agorbaty27/tree-climbing-robot/Motor_2_holders_v2.3mf

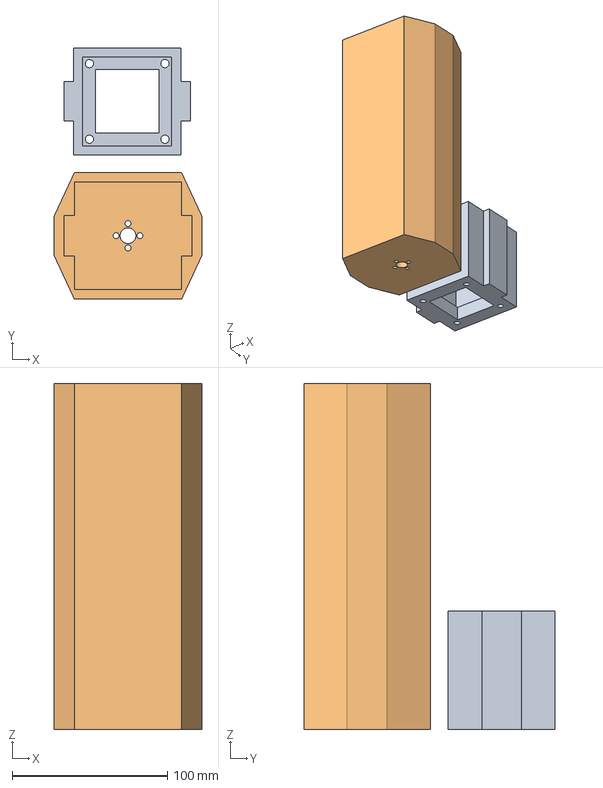
[picture p1: CAD file, 2026-10-24]
Motor_2_holders_v2.3mf
95.0 x 161.7 x 222.8 mm
V2 Holder - Part 1.stl
Long Shaft V2.stl
