agorbaty27/tree-climbing-robot/Part Studio 2 - Part 2.stl

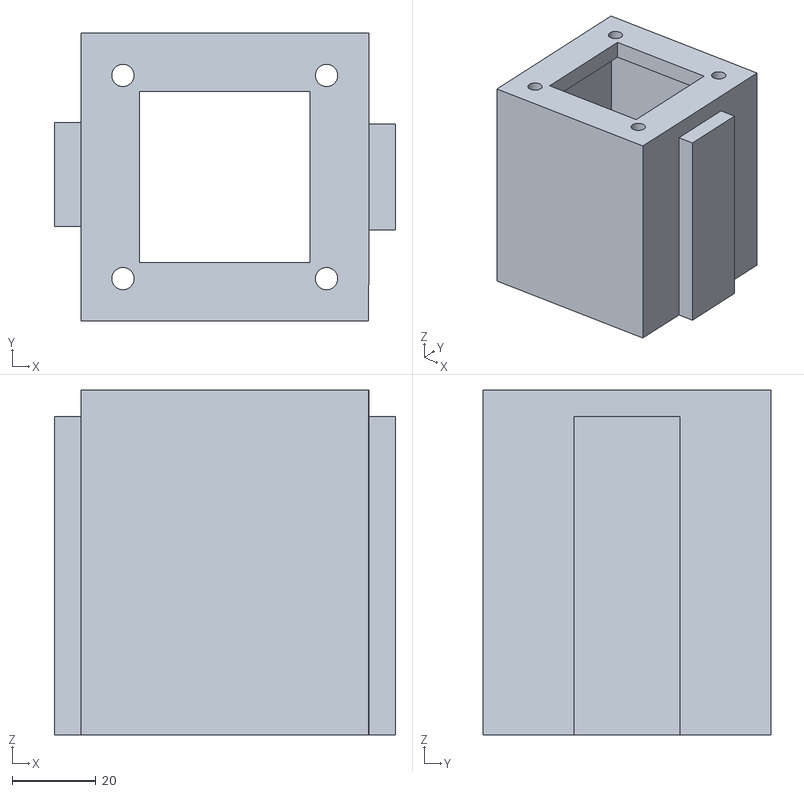
[picture p2: CAD file, 2026-10-24]
Part Studio 2 - Part 2.stl
81.7 x 69.0 x 82.5
