agorbaty27/tree-climbing-robot/Part Studio 3 - Part 1.stl

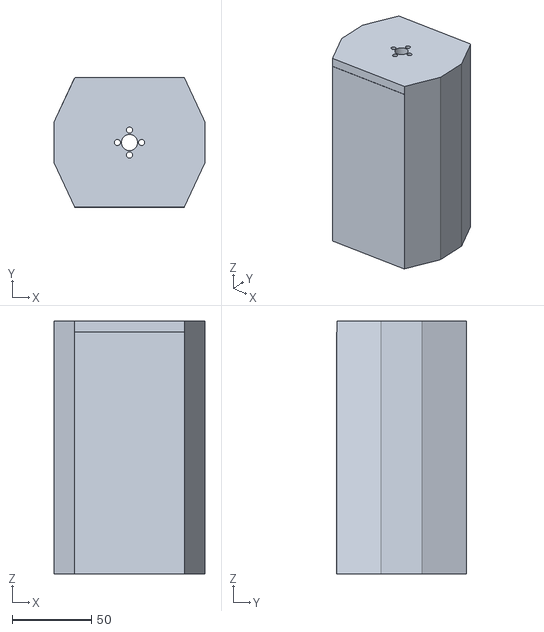
[picture p3: CAD file, 2026-10-24]
Part Studio 3 - Part 1.stl
95.0 x 81.7 x 159.3
