agorbaty27/tree-climbing-robot/Tree Climber | Assembly 1.pdf

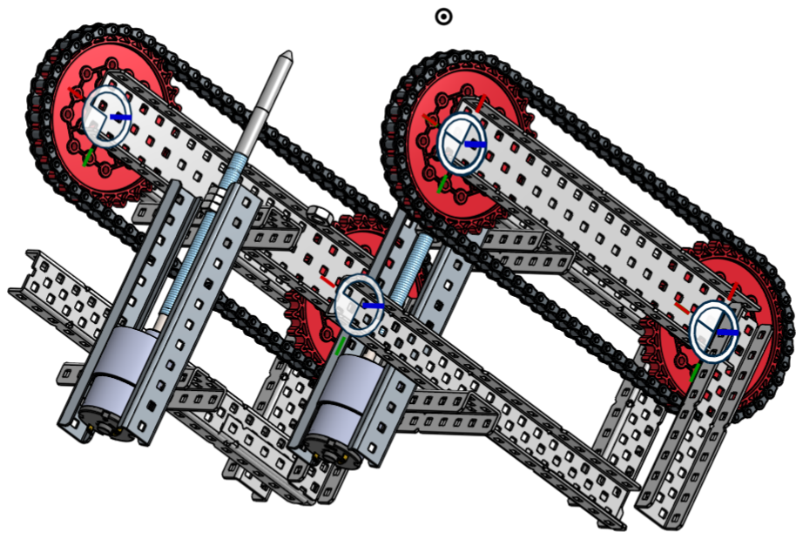
[picture p4: figure]
