agorbaty27/tree-climbing-robot/Tree Climber | Assembly 2.pdf

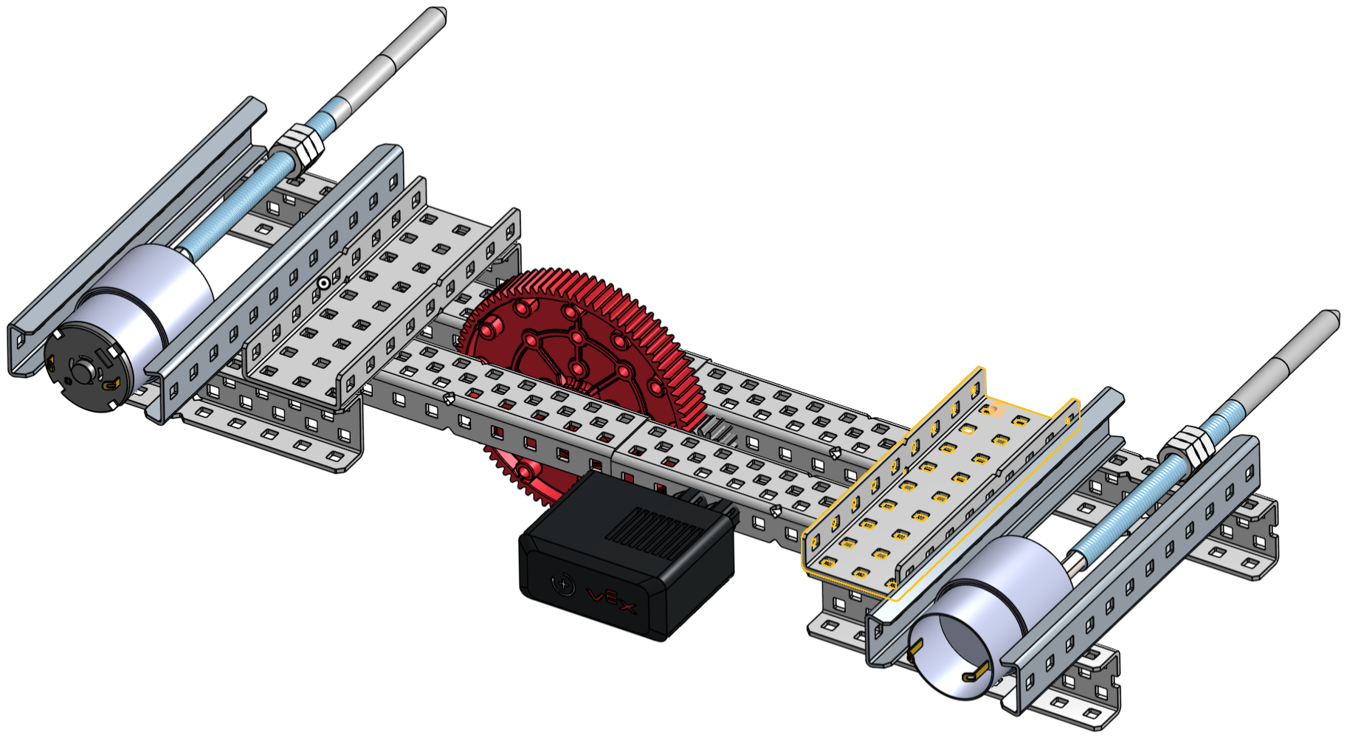
[picture p5: figure]
